prestofuoco/CUTIE-CITRUS/README.md

# computational imaging & telemetry for reconnaissance under suborbit
see CUTIE-CITRUS.pdf for schematics, and layout.pdf for PCB layout.
