prestofuoco/CUTIE-CITRUS/pcb/CUTIE-CITRUS.pdf

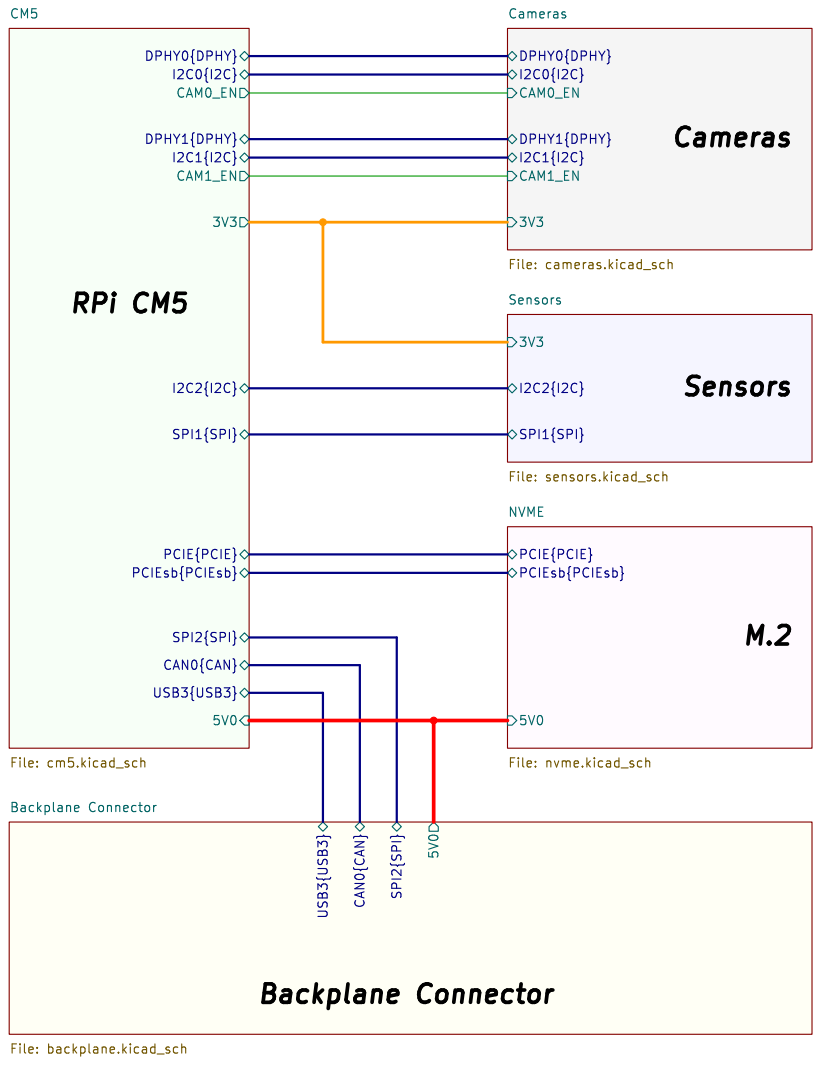
[picture p1: page 1]

I2C1{I2C} Cameras File: cameras.kicad_sch Backplane Connector

SPI1{SPI} Sensors File: sensors.kicad_sch

Id: 1/8 Title: CUTIE-CITRUS PCB

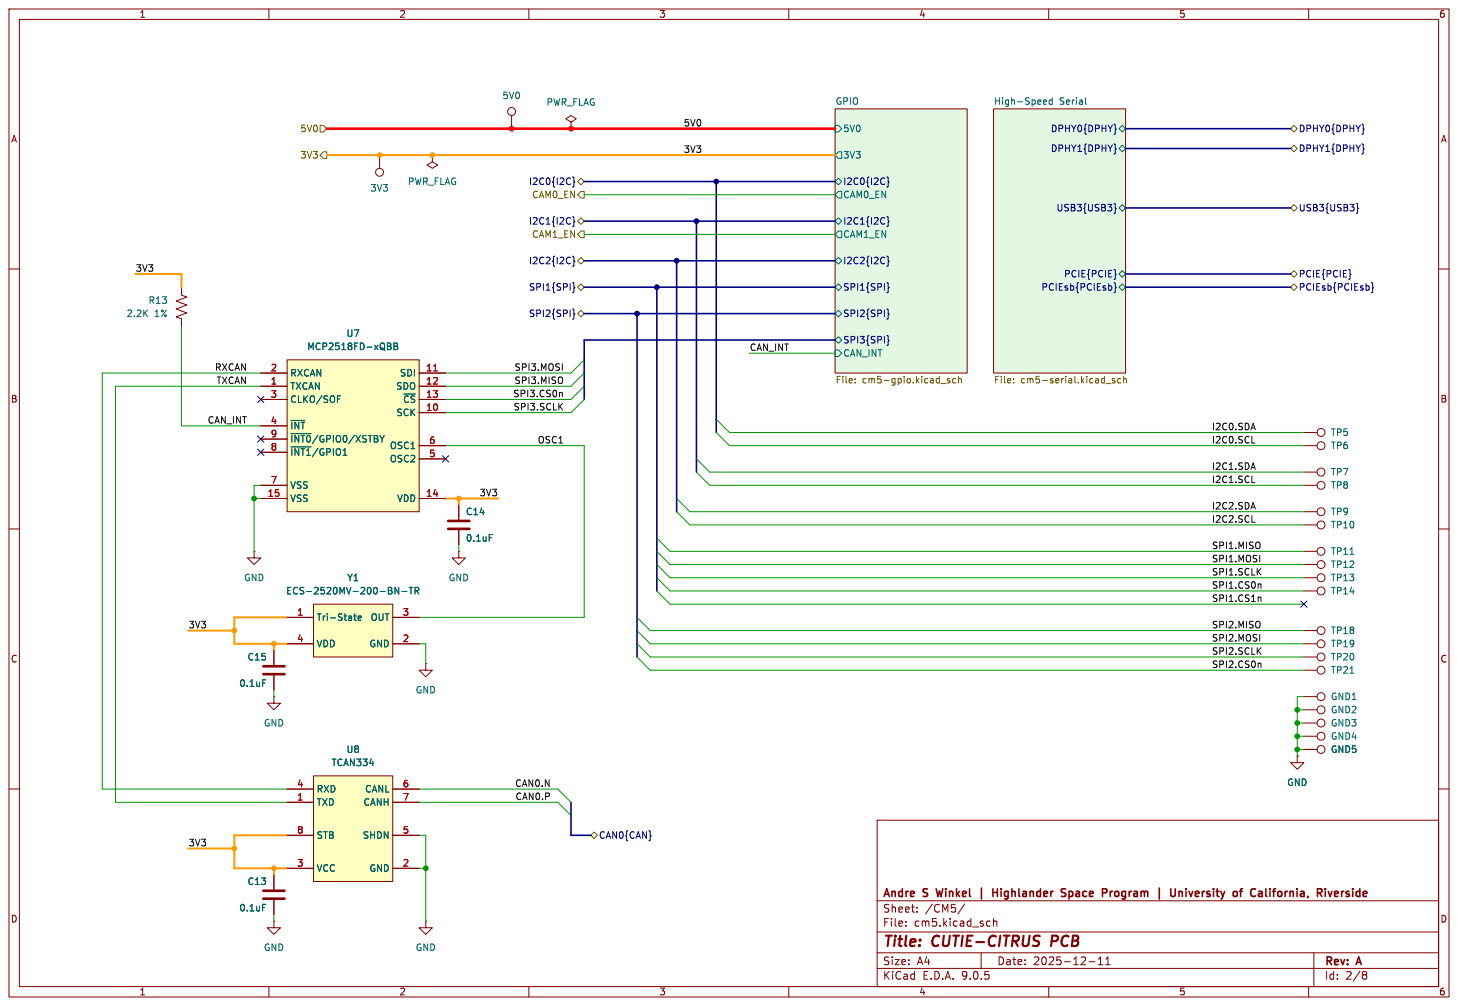
[picture p2: page 2]

Id: 2/8 Title: CUTIE-CITRUS PCB

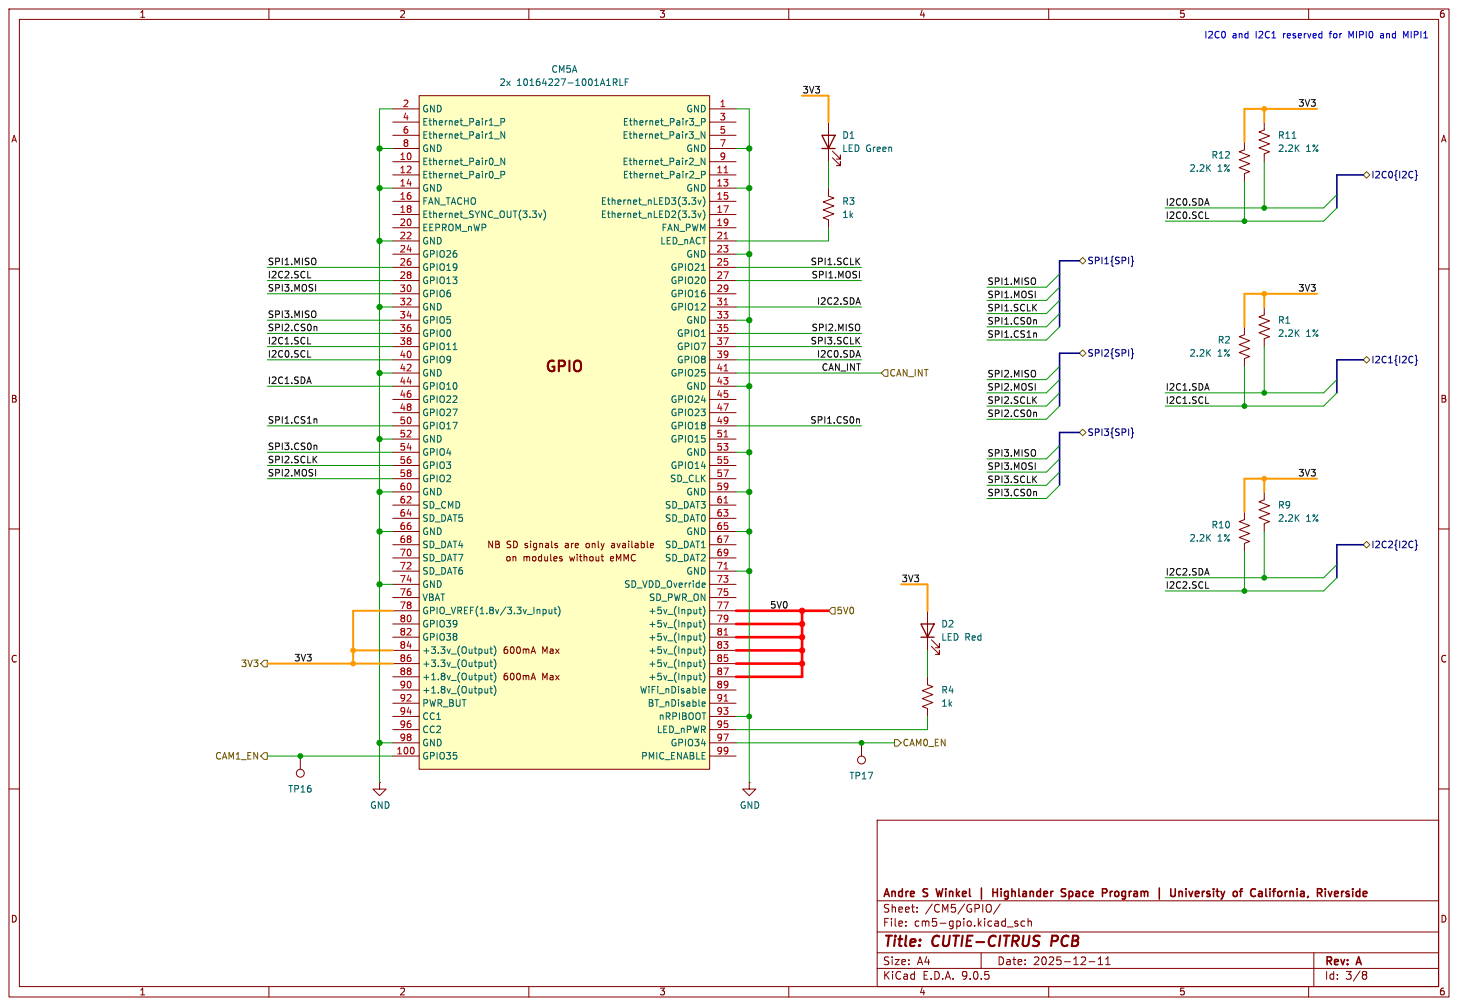
[picture p3: page 3]

I2C0 and I2C1 reserved for MIPI0 and MIPI1

NB SD signals are only available

Id: 3/8 Title: CUTIE-CITRUS PCB

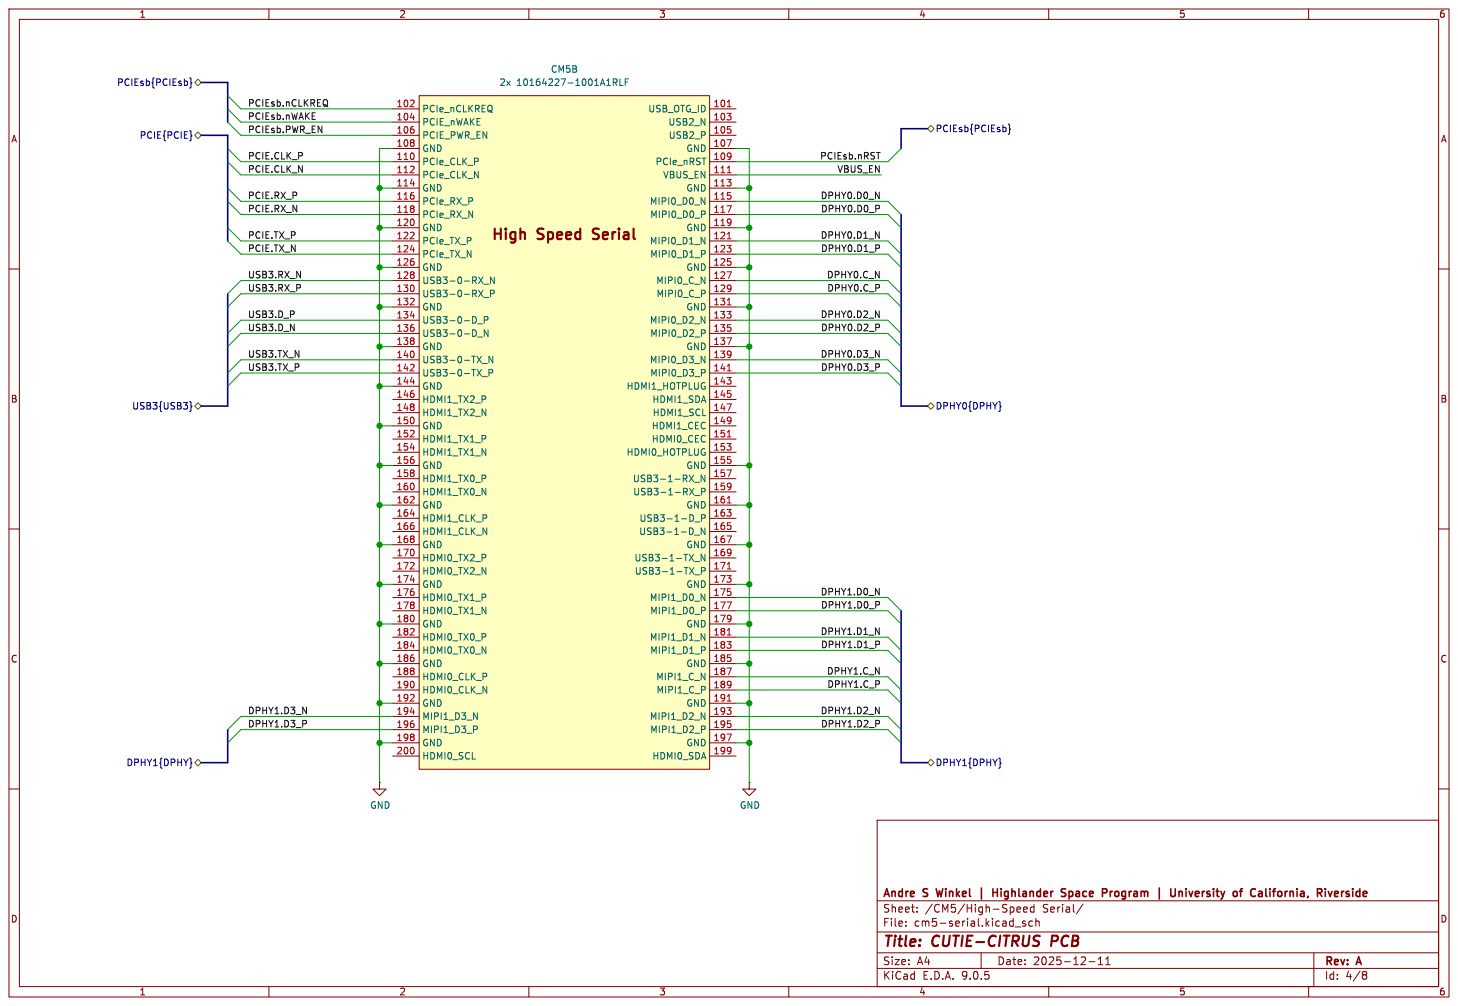
[picture p4: page 4]

Id: 4/8 Title: CUTIE-CITRUS PCB

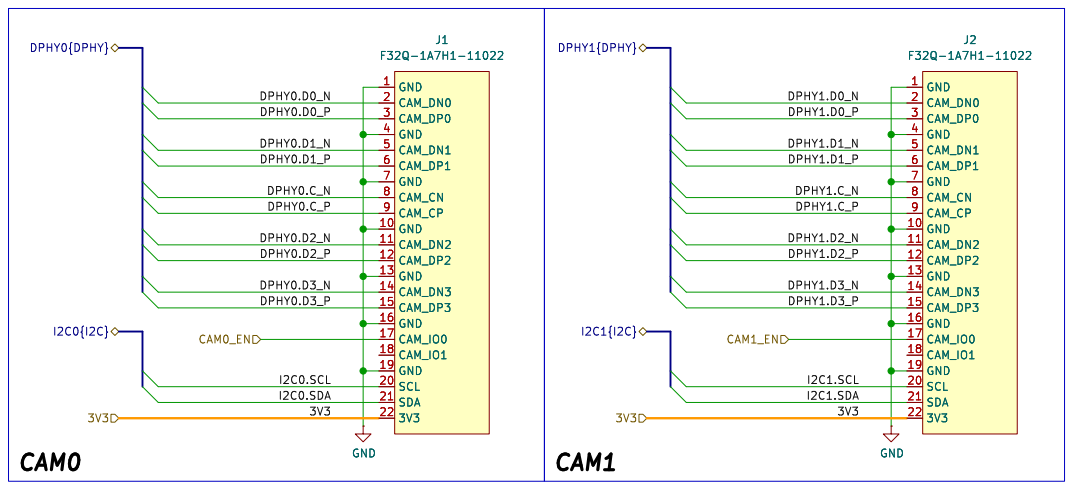
[picture p5: page 5]

Id: 5/8 Title: CUTIE-CITRUS PCB

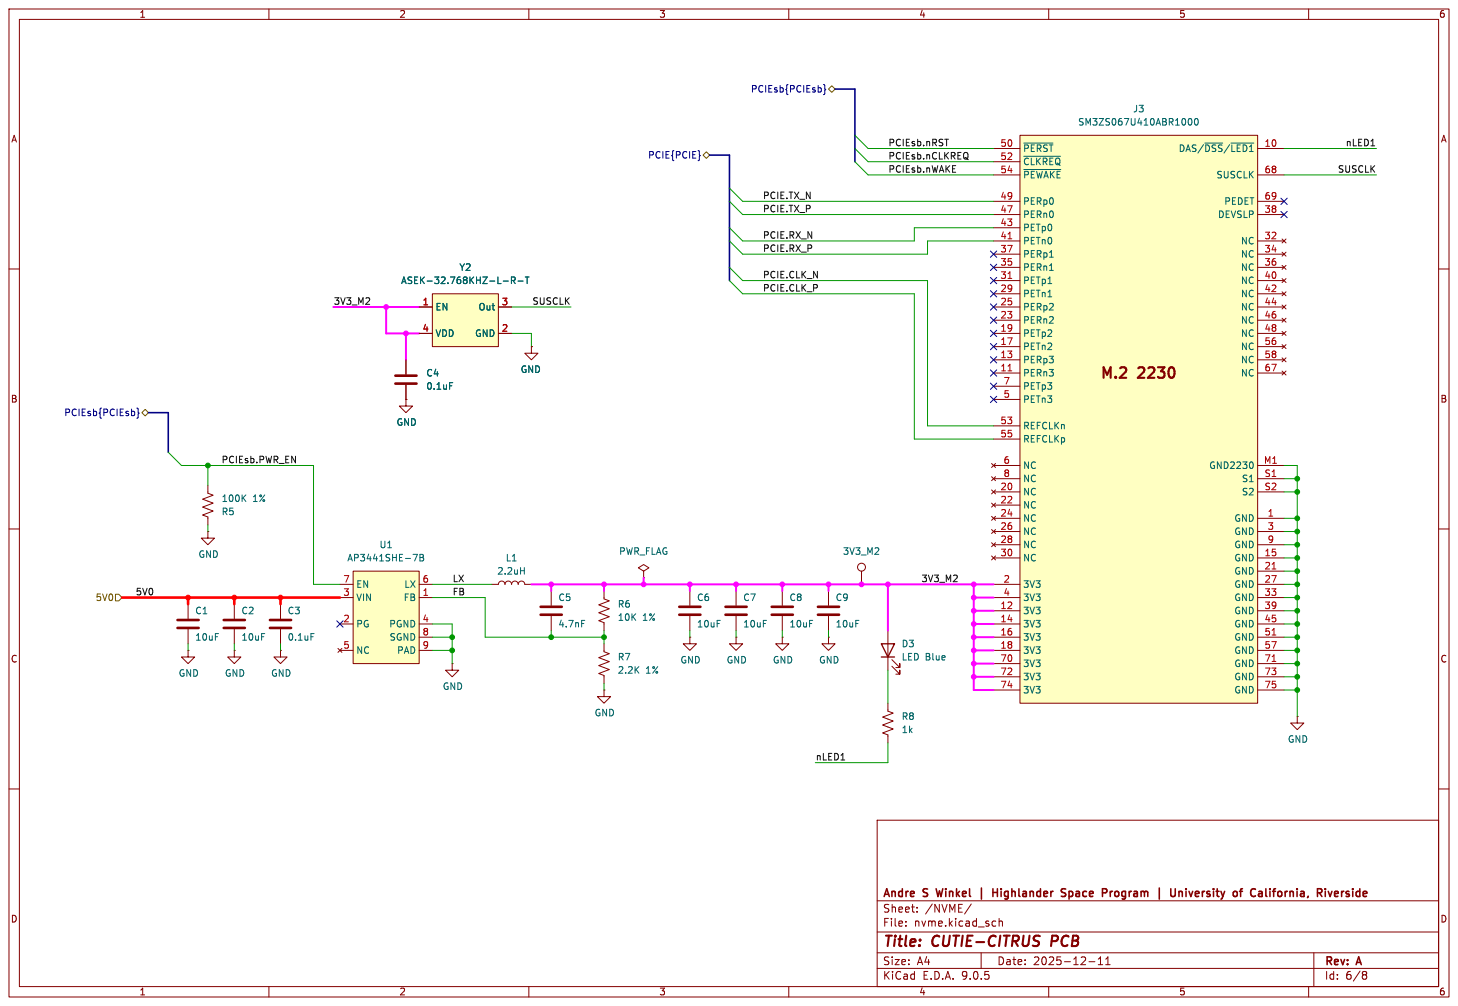
[picture p6: page 6]

PCIEsb.nRST PCIEsb.nCLKREQ

EN 7 VIN 3 PG 2 NC 5

Id: 6/8 Title: CUTIE-CITRUS PCB

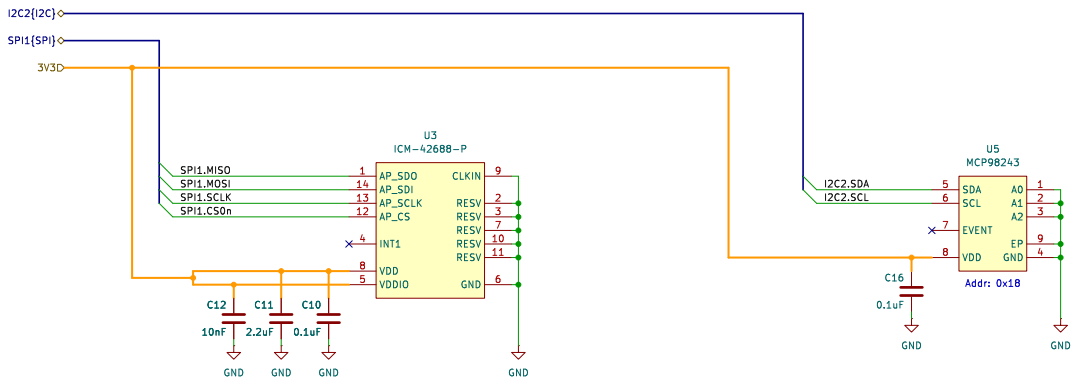
[picture p7: page 7]

Id: 7/8 Title: CUTIE-CITRUS PCB

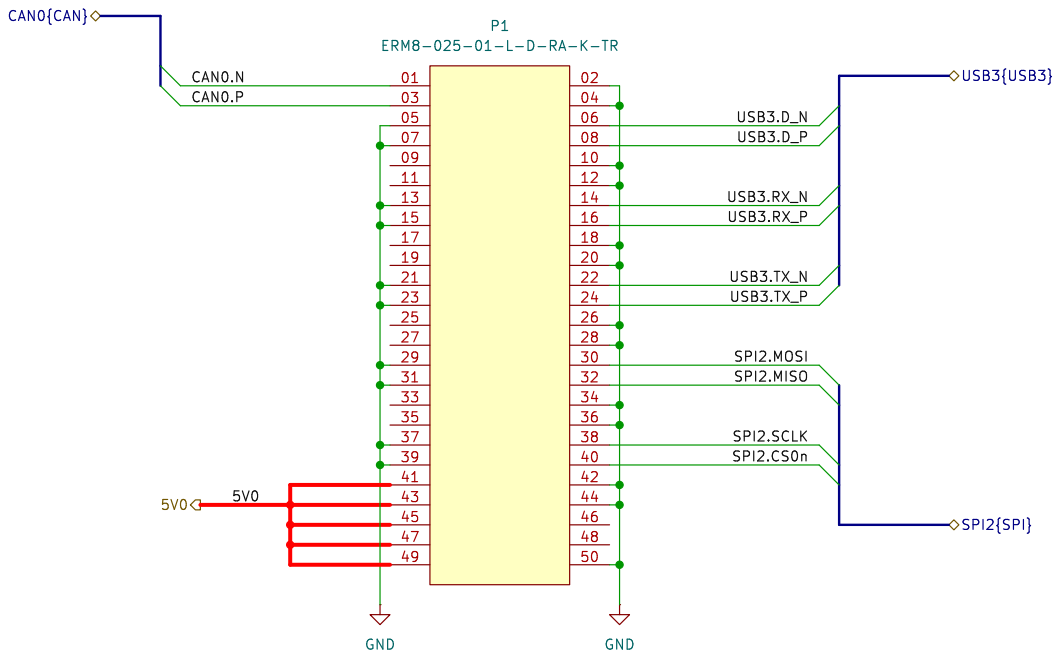
[picture p8: page 8]

47
49

Id: 8/8 Title: CUTIE-CITRUS PCB
