prestofuoco/CUTIE-CITRUS/pcb/CUTIE-CITRUS.kicad_pcb

## KiCad design pcb/CUTIE-CITRUS.kicad_pcb (2026-01-16)

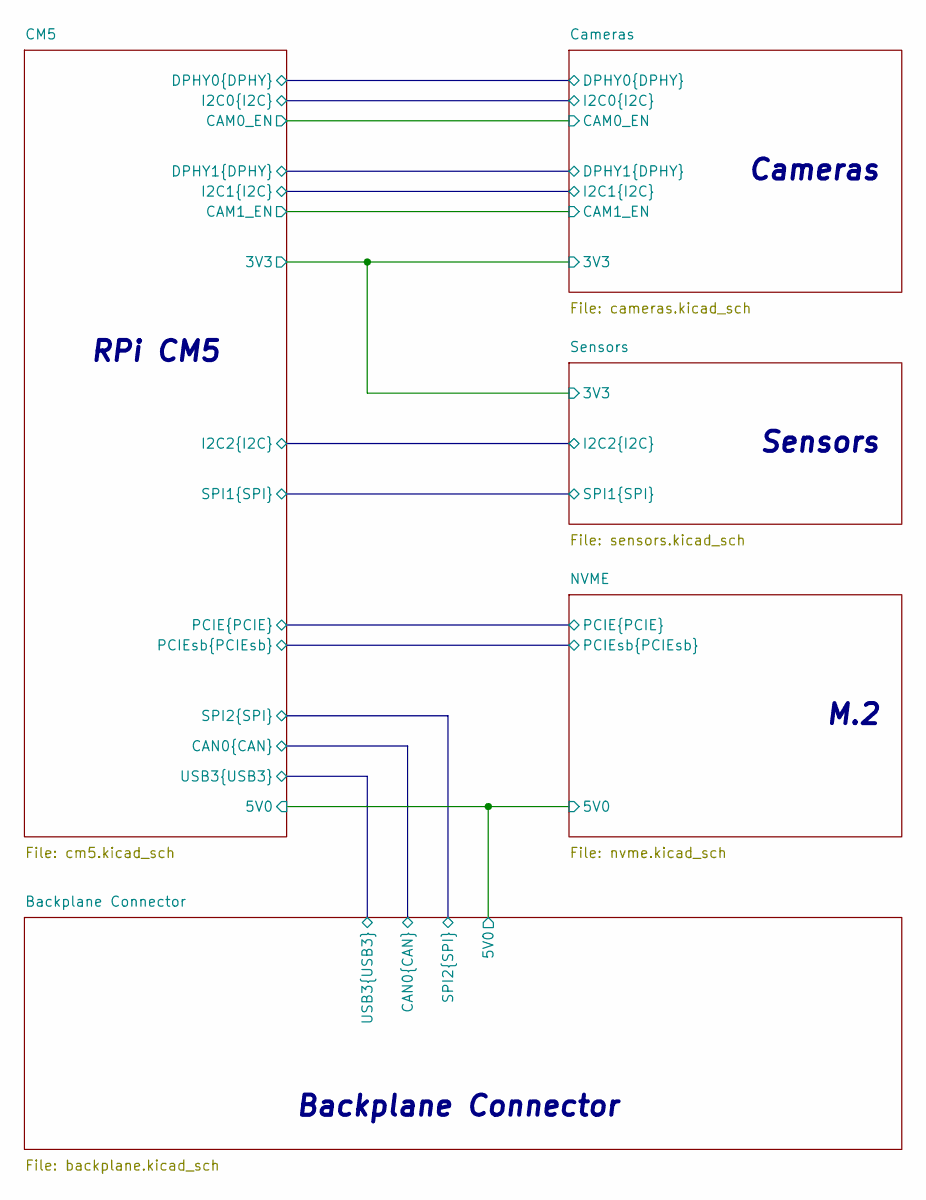
[picture p13: schematic CUTIE-CITRUS.kicad_sch, CUTIE-CITRUS PCB]

Notes on the sheet:
Cameras
Backplane Connector
Sensors
M.2
RPi CM5

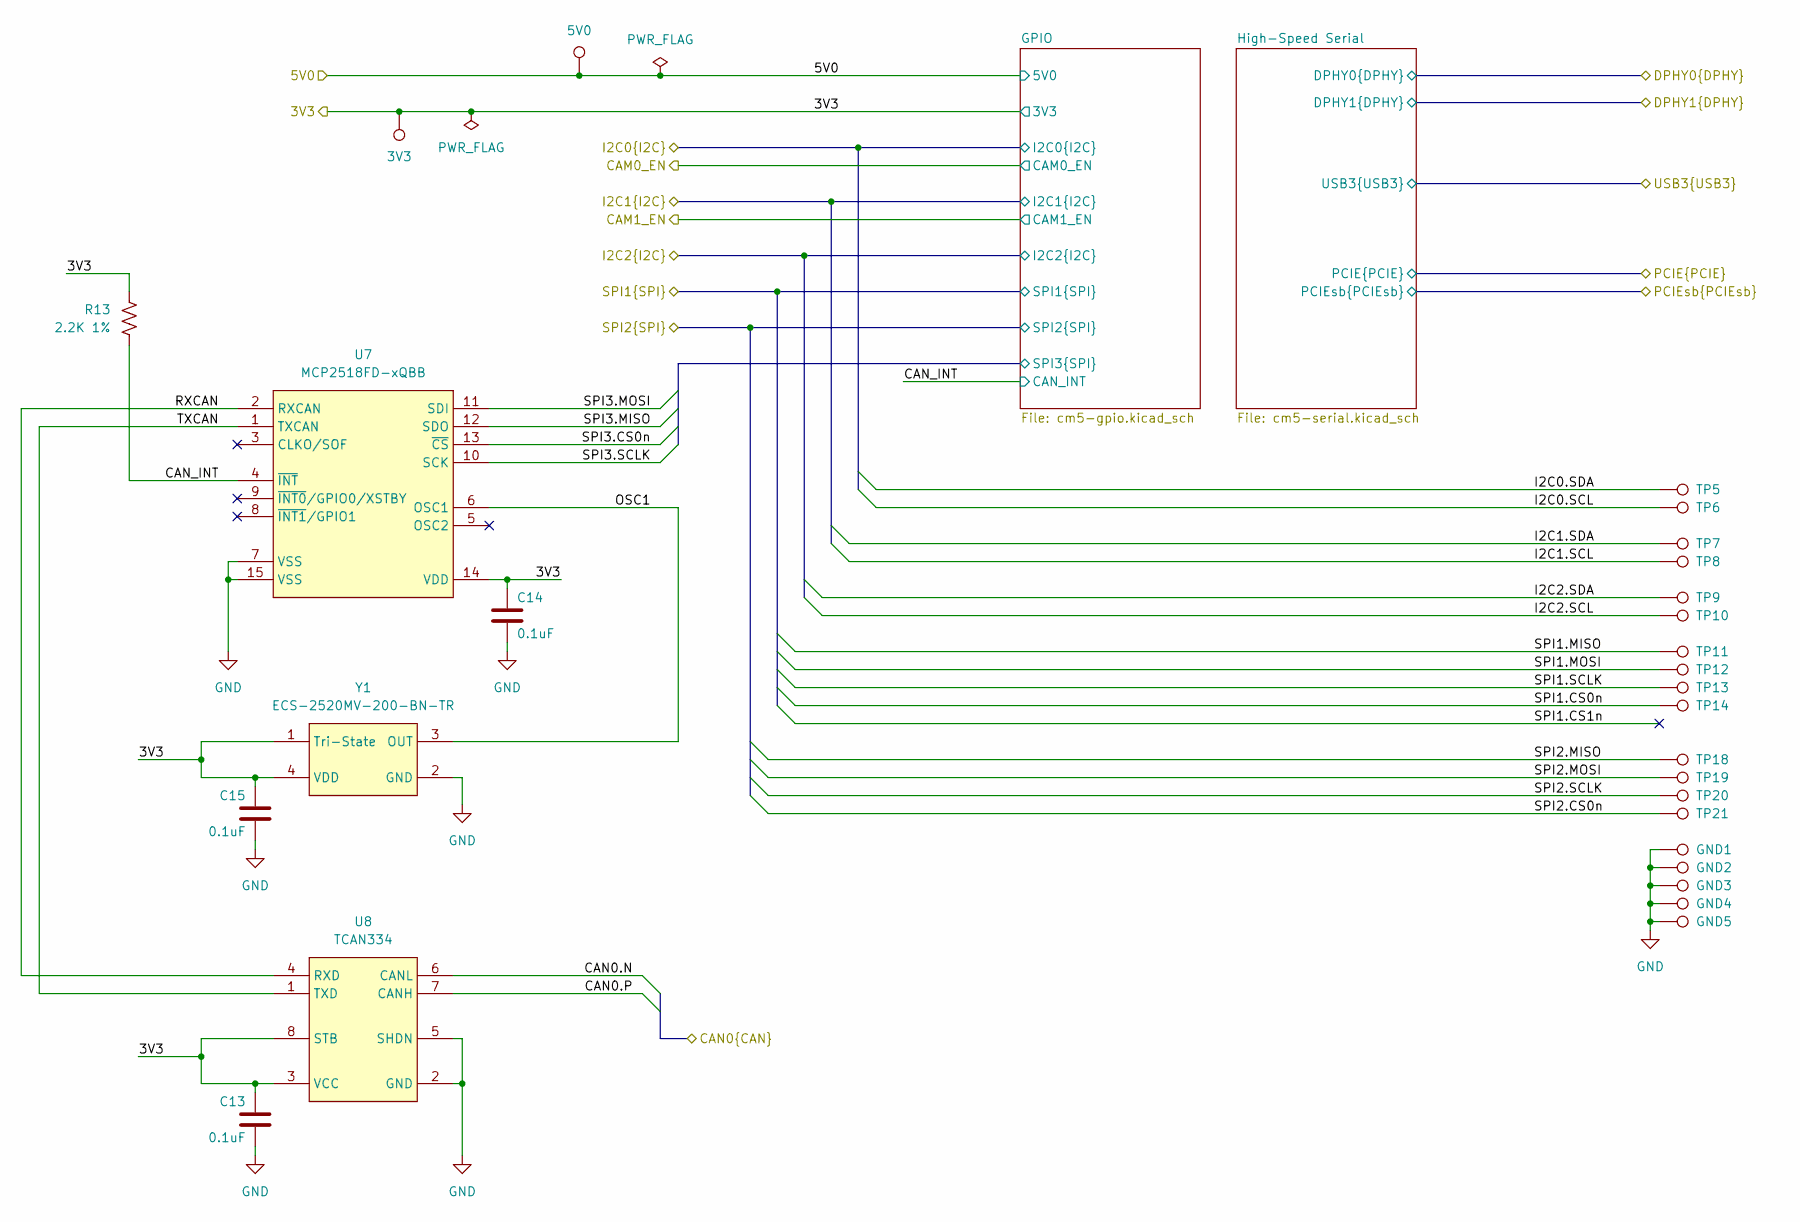
[picture p14: schematic cm5.kicad_sch, CUTIE-CITRUS PCB]

Parts:
3V3, 5V0: TestPoint; TestPoint_Pad_D2.0mm
C13, C14, C15: 0.1uF; C_0402_1005Metric; Part Description 0.1uF 10% 16V Ceramic Capacitor X7R 040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
GND1, GND2, GND3, GND4, GND5: TestPoint; TestPoint_Pad_D1.0mm
R13: 2.2K 1%; R_0402_1005Metric; Part Description Resistor 2.2K M1005 1% 63mW
TP5, TP6, TP7, TP8, TP9, TP10, TP11, TP12, TP13, TP14, TP18, TP19, TP20, TP21: TestPoint; TestPoint_Pad_D1.0mm
U7: MCP2518FD-xQBB; DFN-14-1EP_3x4.5mm_P0.65mm_EP1.65x4.25mm
U8: TCAN334; JEITA_SOIC-8_3.9x4.9mm_P1.27mm
Y1: ECS-2520MV-200-BN-TR; Oscillator_SMD_ECS_2520MV-xxx-xx-4Pin_2.5x2.0mm

Connections:
/Backplane Connector/5V0: 5V0.1; also elsewhere on the board
/Backplane Connector/CAN0.N: U8.6 (CANL); also elsewhere on the board
/Backplane Connector/CAN0.P: U8.7 (CANH); also elsewhere on the board
/Backplane Connector/SPI2.CS0n: TP21.1; also elsewhere on the board
/Backplane Connector/SPI2.MISO: TP18.1; also elsewhere on the board
/Backplane Connector/SPI2.MOSI: TP19.1; also elsewhere on the board
/Backplane Connector/SPI2.SCLK: TP20.1; also elsewhere on the board
/CM5/3V3: 3V3.1, C13.1, C14.1, C15.1, R13.1, U7.14 (VDD), U8.3 (VCC), U8.8 (STB), Y1.1 (Tri-State), Y1.4 (VDD); also elsewhere on the board
/CM5/CAN_INT: R13.2, U7.4 (~INT); also elsewhere on the board
/CM5/GPIO/SPI3.CS0n: U7.13 (~CS); also elsewhere on the board
/CM5/GPIO/SPI3.MISO: U7.12 (SDO); also elsewhere on the board
/CM5/GPIO/SPI3.MOSI: U7.11 (SDI); also elsewhere on the board
/CM5/GPIO/SPI3.SCLK: U7.10 (SCK); also elsewhere on the board
/CM5/I2C0.SCL: TP6.1; also elsewhere on the board
/CM5/I2C0.SDA: TP5.1; also elsewhere on the board
/CM5/I2C1.SCL: TP8.1; also elsewhere on the board
/CM5/I2C1.SDA: TP7.1; also elsewhere on the board
/CM5/I2C2.SCL: TP10.1; also elsewhere on the board
/CM5/I2C2.SDA: TP9.1; also elsewhere on the board
/CM5/OSC1: U7.6 (OSC1), Y1.3 (OUT)
/CM5/RXCAN: U7.2 (RXCAN), U8.4 (RXD)
/CM5/SPI1.CS0n: TP14.1; also elsewhere on the board
/CM5/SPI1.MISO: TP11.1; also elsewhere on the board
/CM5/SPI1.MOSI: TP12.1; also elsewhere on the board
/CM5/SPI1.SCLK: TP13.1; also elsewhere on the board
/CM5/TXCAN: U7.1 (TXCAN), U8.1 (TXD)
GND: C13.2, C14.2, C15.2, GND1.1, GND2.1, GND3.1, GND4.1, GND5.1, U7.7 (VSS), U7.15 (VSS), U8.2 (GND), U8.5 (SHDN), Y1.2 (GND); also elsewhere on the board

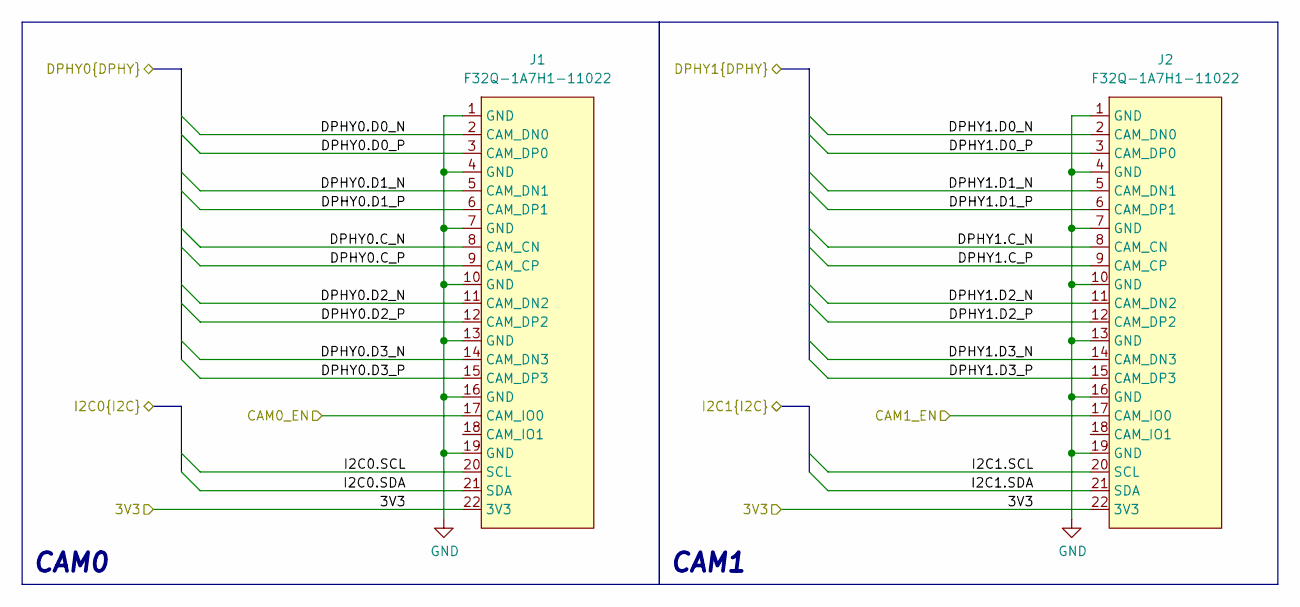
[picture p15: schematic cameras.kicad_sch, CUTIE-CITRUS PCB]

Parts:
J1, J2: F32Q-1A7H1-11022; Hirose_FH12-22S-0.5SH_1x22-1MP_P0.50mm_Horizontal

Connections:
/CM5/3V3: J1.22 (3V3), J2.22 (3V3); also elsewhere on the board
/CM5/CAM0_EN: J1.17 (CAM_IO0); also elsewhere on the board
/CM5/CAM1_EN: J2.17 (CAM_IO0); also elsewhere on the board
/CM5/DPHY0.C_N: J1.8 (CAM_CN); also elsewhere on the board
/CM5/DPHY0.C_P: J1.9 (CAM_CP); also elsewhere on the board
/CM5/DPHY0.D0_N: J1.2 (CAM_DN0); also elsewhere on the board
/CM5/DPHY0.D0_P: J1.3 (CAM_DP0); also elsewhere on the board
/CM5/DPHY0.D1_N: J1.5 (CAM_DN1); also elsewhere on the board
/CM5/DPHY0.D1_P: J1.6 (CAM_DP1); also elsewhere on the board
/CM5/DPHY0.D2_N: J1.11 (CAM_DN2); also elsewhere on the board
/CM5/DPHY0.D2_P: J1.12 (CAM_DP2); also elsewhere on the board
/CM5/DPHY0.D3_N: J1.14 (CAM_DN3); also elsewhere on the board
/CM5/DPHY0.D3_P: J1.15 (CAM_DP3); also elsewhere on the board
/CM5/DPHY1.C_N: J2.8 (CAM_CN); also elsewhere on the board
/CM5/DPHY1.C_P: J2.9 (CAM_CP); also elsewhere on the board
/CM5/DPHY1.D0_N: J2.2 (CAM_DN0); also elsewhere on the board
/CM5/DPHY1.D0_P: J2.3 (CAM_DP0); also elsewhere on the board
/CM5/DPHY1.D1_N: J2.5 (CAM_DN1); also elsewhere on the board
/CM5/DPHY1.D1_P: J2.6 (CAM_DP1); also elsewhere on the board
/CM5/DPHY1.D2_N: J2.11 (CAM_DN2); also elsewhere on the board
/CM5/DPHY1.D2_P: J2.12 (CAM_DP2); also elsewhere on the board
/CM5/DPHY1.D3_N: J2.14 (CAM_DN3); also elsewhere on the board
/CM5/DPHY1.D3_P: J2.15 (CAM_DP3); also elsewhere on the board
/CM5/I2C0.SCL: J1.20 (SCL); also elsewhere on the board
/CM5/I2C0.SDA: J1.21 (SDA); also elsewhere on the board
/CM5/I2C1.SCL: J2.20 (SCL); also elsewhere on the board
/CM5/I2C1.SDA: J2.21 (SDA); also elsewhere on the board
GND: J1.1 (GND), J1.4 (GND), J1.7 (GND), J1.10 (GND), J1.13 (GND), J1.16 (GND), J1.19 (GND), J2.1 (GND), J2.4 (GND), J2.7 (GND), J2.10 (GND), J2.13 (GND), J2.16 (GND), J2.19 (GND); also elsewhere on the board

Notes on the sheet:
CAM1
CAM0

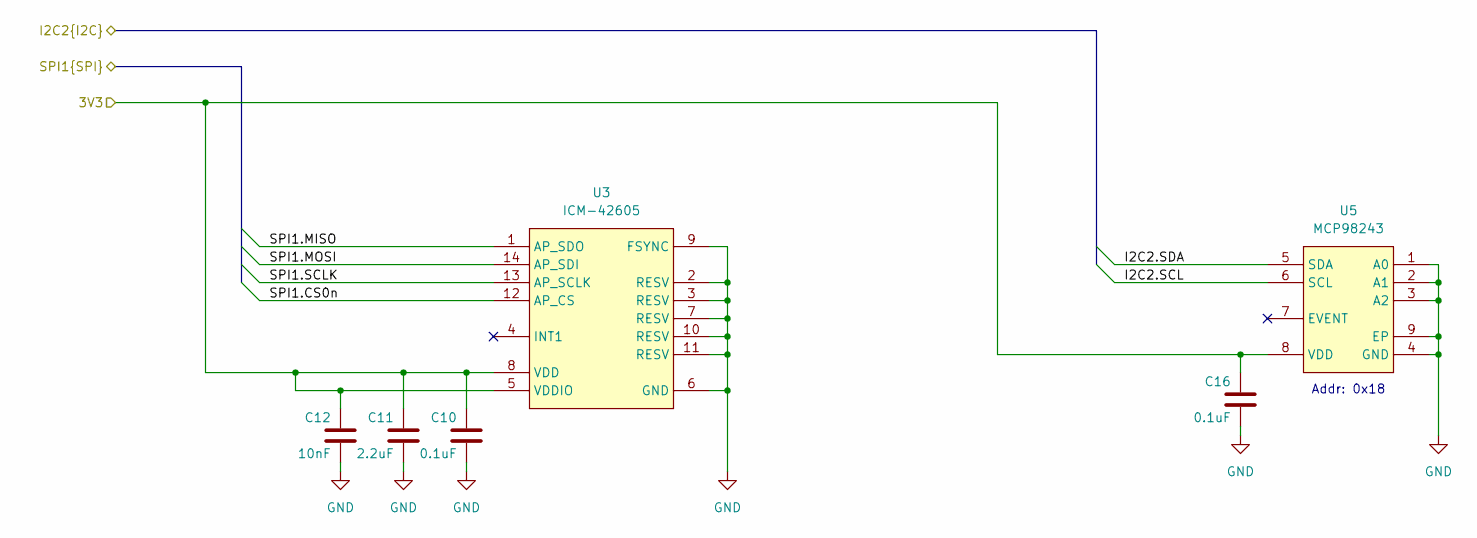
[picture p16: schematic sensors.kicad_sch, CUTIE-CITRUS PCB]

Parts:
C10, C16: 0.1uF; C_0402_1005Metric
C11: 2.2uF; C_0402_1005Metric; Part Description 4.7nF capacitor 0402
C12: 10nF; C_0402_1005Metric; Part Description 4.7nF capacitor 0402
U3: ICM-42605; LGA-14_3x2.5mm_P0.5mm_LayoutBorder3x4y
U5: MCP98243; DFN-8-1EP_3x2mm_P0.5mm_EP1.3x1.5mm

Connections:
/CM5/3V3: C10.1, C11.1, C12.1, C16.1, U3.5 (VDDIO), U3.8 (VDD), U5.8 (VDD); also elsewhere on the board
/CM5/I2C2.SCL: U5.6 (SCL); also elsewhere on the board
/CM5/I2C2.SDA: U5.5 (SDA); also elsewhere on the board
/CM5/SPI1.CS0n: U3.12 (AP_CS); also elsewhere on the board
/CM5/SPI1.MISO: U3.1 (AP_SDO); also elsewhere on the board
/CM5/SPI1.MOSI: U3.14 (AP_SDI); also elsewhere on the board
/CM5/SPI1.SCLK: U3.13 (AP_SCLK); also elsewhere on the board
GND: C10.2, C11.2, C12.2, C16.2, U3.2 (RESV), U3.3 (RESV), U3.6 (GND), U3.7 (RESV), U3.9 (FSYNC), U3.10 (RESV), U3.11 (RESV), U5.1 (A0), U5.2 (A1), U5.3 (A2), U5.4 (GND), U5.9 (EP); also elsewhere on the board

Notes on the sheet:
Addr: 0x18

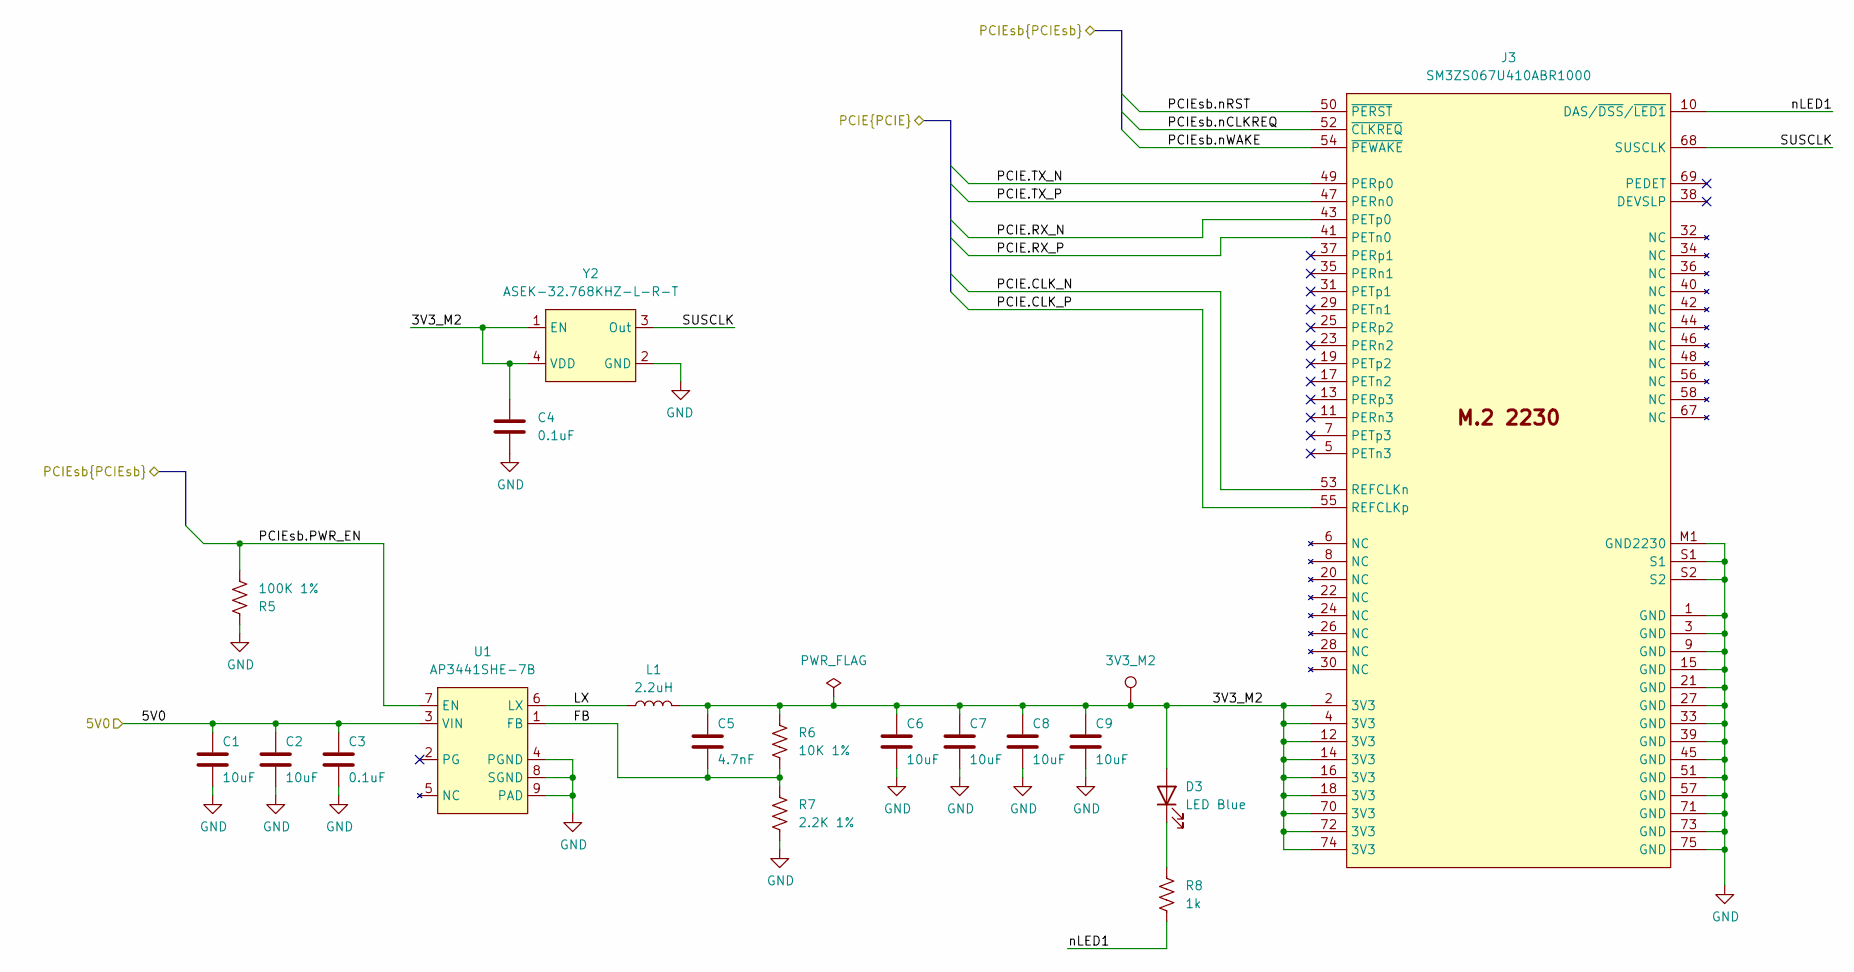
[picture p17: schematic nvme.kicad_sch, CUTIE-CITRUS PCB]

Parts:
3V3_M2: TestPoint; TestPoint_Pad_D1.0mm
C1, C2, C6, C7, C8, C9: 10uF; C_0805_2012Metric
C3, C4: 0.1uF; C_0402_1005Metric
C5: 4.7nF; C_0402_1005Metric
D3: LED Blue; LED_0603_1608Metric
J3: SM3ZS067U410ABR1000; 2230m2
L1: 2.2uH; L_Vishay_IHLP-1616
R5: 100K 1%; R_0402_1005Metric
R6: 10K 1%; R_0402_1005Metric
R7: 2.2K 1%; R_0402_1005Metric
R8: 1k; R_0402_1005Metric
U1: AP3441SHE-7B; DFN-8-1EP_2x2mm_P0.5mm_EP1.05x1.75mm
Y2: ASEK-32.768KHZ-L-R-T; Crystal_SMD_3225-4Pin_3.2x2.5mm

Connections:
/Backplane Connector/5V0: C1.1, C2.1, C3.1, U1.3 (VIN); also elsewhere on the board
/CM5/PCIE.CLK_N: J3.53 (REFCLKn); also elsewhere on the board
/CM5/PCIE.CLK_P: J3.55 (REFCLKp); also elsewhere on the board
/CM5/PCIE.RX_N: J3.43 (PETp0); also elsewhere on the board
/CM5/PCIE.RX_P: J3.41 (PETn0); also elsewhere on the board
/CM5/PCIE.TX_N: J3.49 (PERp0); also elsewhere on the board
/CM5/PCIE.TX_P: J3.47 (PERn0); also elsewhere on the board
/CM5/PCIEsb.PWR_EN: R5.1, U1.7 (EN); also elsewhere on the board
/CM5/PCIEsb.nCLKREQ: J3.52 (~CLKREQ); also elsewhere on the board
/CM5/PCIEsb.nRST: J3.50 (~PERST); also elsewhere on the board
/CM5/PCIEsb.nWAKE: J3.54 (~PEWAKE); also elsewhere on the board
/NVME/3V3_M2: 3V3_M2.1, C4.1, C5.1, C6.1, C7.1, C8.1, C9.1, D3.2 (A), J3.2 (3V3), J3.4 (3V3), J3.12 (3V3), J3.14 (3V3), J3.16 (3V3), J3.18 (3V3), J3.70 (3V3), J3.72 (3V3), J3.74 (3V3), L1.2, R6.1, Y2.1 (EN), Y2.4 (VDD)
/NVME/FB: C5.2, R6.2, R7.1, U1.1 (FB)
/NVME/LX: L1.1, U1.6 (LX)
/NVME/SUSCLK: J3.68 (SUSCLK), Y2.3 (Out)
/NVME/nLED1: J3.10 (DAS/~DSS/~LED1), R8.2
GND: C1.2, C2.2, C3.2, C4.2, C6.2, C7.2, C8.2, C9.2, J3.1 (GND), J3.3 (GND), J3.9 (GND), J3.15 (GND), J3.21 (GND), J3.27 (GND), J3.33 (GND), J3.39 (GND), J3.45 (GND), J3.51 (GND), J3.57 (GND), J3.71 (GND), J3.73 (GND), J3.75 (GND), J3.M1 (GND2230), J3.S1, J3.S2, R5.2, R7.2, U1.4 (PGND), U1.8 (SGND), U1.9 (PAD), Y2.2 (GND); also elsewhere on the board
unnamed: D3.1 (K), R8.1

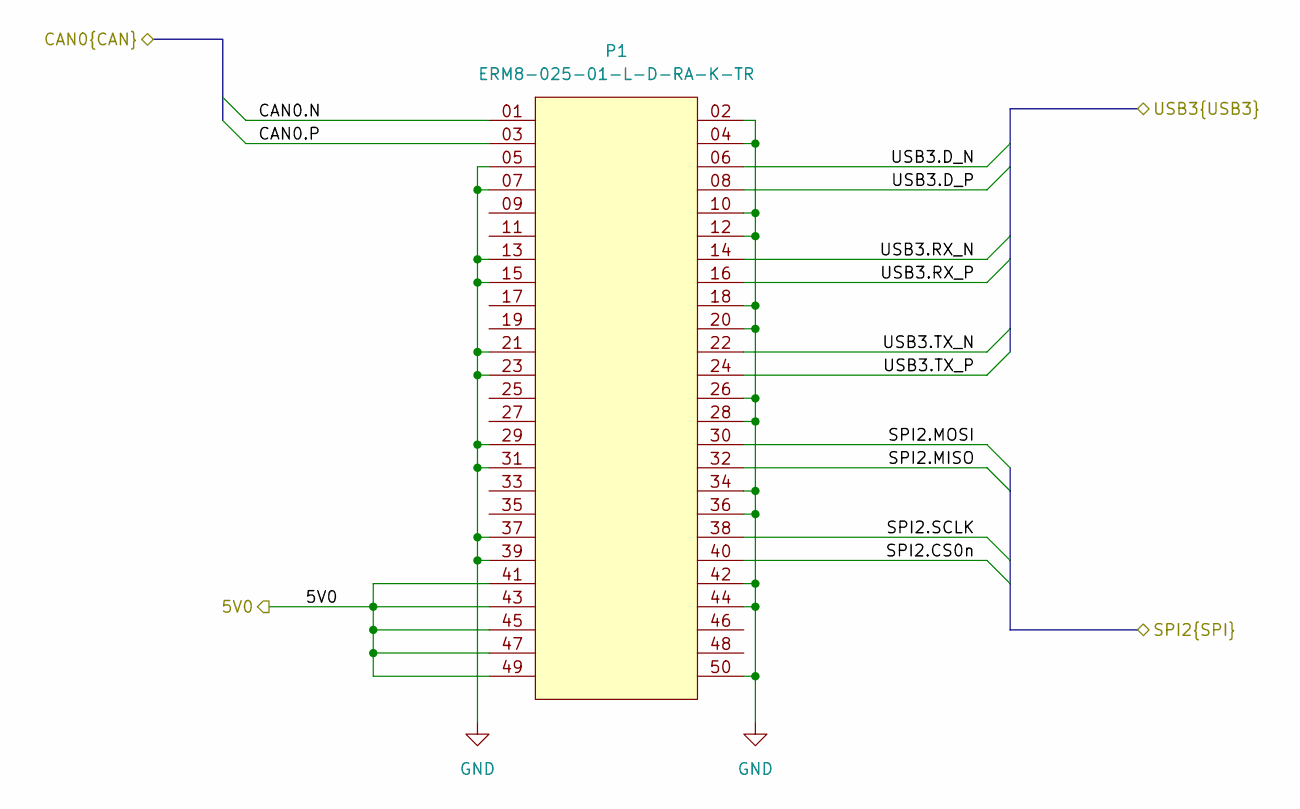
[picture p18: schematic backplane.kicad_sch, CUTIE-CITRUS PCB]

Parts:
P1: ERM8-025-01-L-D-RA-K-TR; SAMTEC_ERM8-025-XX-X-D-RA-XX

Connections:
/Backplane Connector/5V0: P1.41, P1.43, P1.45, P1.47, P1.49; also elsewhere on the board
/Backplane Connector/CAN0.N: P1.01; also elsewhere on the board
/Backplane Connector/CAN0.P: P1.03; also elsewhere on the board
/Backplane Connector/SPI2.CS0n: P1.40; also elsewhere on the board
/Backplane Connector/SPI2.MISO: P1.32; also elsewhere on the board
/Backplane Connector/SPI2.MOSI: P1.30; also elsewhere on the board
/Backplane Connector/SPI2.SCLK: P1.38; also elsewhere on the board
/Backplane Connector/USB3.D_N: P1.06; also elsewhere on the board
/Backplane Connector/USB3.D_P: P1.08; also elsewhere on the board
/Backplane Connector/USB3.RX_N: P1.14; also elsewhere on the board
/Backplane Connector/USB3.RX_P: P1.16; also elsewhere on the board
/Backplane Connector/USB3.TX_N: P1.22; also elsewhere on the board
/Backplane Connector/USB3.TX_P: P1.24; also elsewhere on the board
GND: P1.02, P1.04, P1.05, P1.07, P1.10, P1.12, P1.13, P1.15, P1.18, P1.20, P1.21, P1.23, P1.26, P1.28, P1.29, P1.31, P1.34, P1.36, P1.37, P1.39, P1.42, P1.44, P1.50; also elsewhere on the board

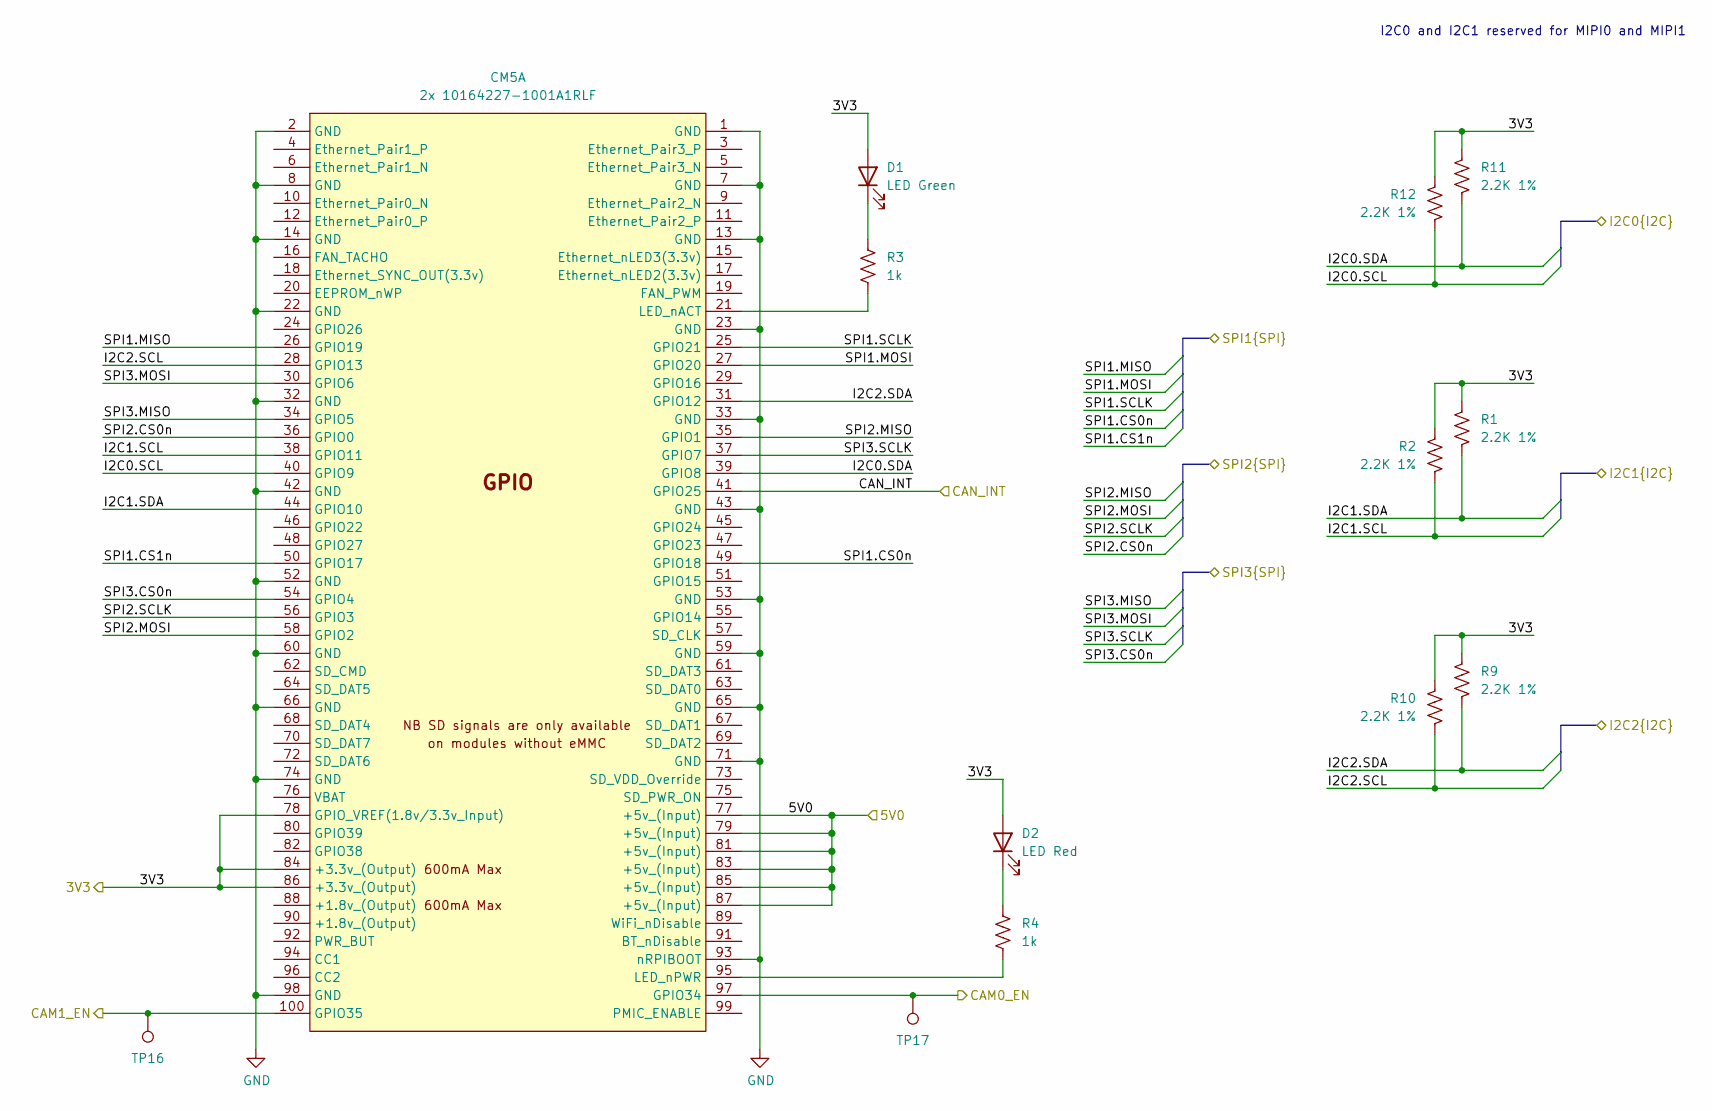
[picture p19: schematic cm5-gpio.kicad_sch, CUTIE-CITRUS PCB]

Parts:
CM5: 2x 10164227-1001A1RLF; RPi-CM5
D1: LED Green; LED_0603_1608Metric
D2: LED Red; LED_0603_1608Metric
R1, R2, R9, R10, R11, R12: 2.2K 1%; R_0402_1005Metric
R3, R4: 1k; R_0402_1005Metric
TP16, TP17: TestPoint; TestPoint_Pad_D1.0mm

Connections:
/Backplane Connector/5V0: CM5.77 (+5v_(Input)), CM5.79 (+5v_(Input)), CM5.81 (+5v_(Input)), CM5.83 (+5v_(Input)), CM5.85 (+5v_(Input)), CM5.87 (+5v_(Input)); also elsewhere on the board
/Backplane Connector/SPI2.CS0n: CM5.36 (GPIO0); also elsewhere on the board
/Backplane Connector/SPI2.MISO: CM5.35 (GPIO1); also elsewhere on the board
/Backplane Connector/SPI2.MOSI: CM5.58 (GPIO2); also elsewhere on the board
/Backplane Connector/SPI2.SCLK: CM5.56 (GPIO3); also elsewhere on the board
/CM5/3V3: CM5.78 (GPIO_VREF(1.8v/3.3v_Input)), CM5.84 (+3.3v_(Output)), CM5.86 (+3.3v_(Output)), D1.2 (A), D2.2 (A), R1.1, R2.1, R9.1, R10.1, R11.1, R12.1; also elsewhere on the board
/CM5/CAM0_EN: CM5.97 (GPIO34), TP17.1; also elsewhere on the board
/CM5/CAM1_EN: CM5.100 (GPIO35), TP16.1; also elsewhere on the board
/CM5/CAN_INT: CM5.41 (GPIO25); also elsewhere on the board
/CM5/GPIO/SPI3.CS0n: CM5.54 (GPIO4); also elsewhere on the board
/CM5/GPIO/SPI3.MISO: CM5.34 (GPIO5); also elsewhere on the board
/CM5/GPIO/SPI3.MOSI: CM5.30 (GPIO6); also elsewhere on the board
/CM5/GPIO/SPI3.SCLK: CM5.37 (GPIO7); also elsewhere on the board
/CM5/I2C0.SCL: CM5.40 (GPIO9), R12.2; also elsewhere on the board
/CM5/I2C0.SDA: CM5.39 (GPIO8), R11.2; also elsewhere on the board
/CM5/I2C1.SCL: CM5.38 (GPIO11), R2.2; also elsewhere on the board
/CM5/I2C1.SDA: CM5.44 (GPIO10), R1.2; also elsewhere on the board
/CM5/I2C2.SCL: CM5.28 (GPIO13), R10.2; also elsewhere on the board
/CM5/I2C2.SDA: CM5.31 (GPIO12), R9.2; also elsewhere on the board
/CM5/SPI1.CS0n: CM5.49 (GPIO18); also elsewhere on the board
/CM5/SPI1.CS1n: CM5.50 (GPIO17)
/CM5/SPI1.MISO: CM5.26 (GPIO19); also elsewhere on the board
/CM5/SPI1.MOSI: CM5.27 (GPIO20); also elsewhere on the board
/CM5/SPI1.SCLK: CM5.25 (GPIO21); also elsewhere on the board
GND: CM5.1 (GND), CM5.2 (GND), CM5.7 (GND), CM5.8 (GND), CM5.13 (GND), CM5.14 (GND), CM5.22 (GND), CM5.23 (GND), CM5.32 (GND), CM5.33 (GND), CM5.42 (GND), CM5.43 (GND), CM5.52 (GND), CM5.53 (GND), CM5.59 (GND), CM5.60 (GND), CM5.65 (GND), CM5.66 (GND), CM5.71 (GND), CM5.74 (GND), CM5.93 (nRPIBOOT), CM5.98 (GND); also elsewhere on the board
unnamed: CM5.21 (LED_nACT), R3.2
unnamed: CM5.95 (LED_nPWR), R4.2
unnamed: D1.1 (K), R3.1
unnamed: D2.1 (K), R4.1

Notes on the sheet:
I2C0 and I2C1 reserved for MIPI0 and MIPI1

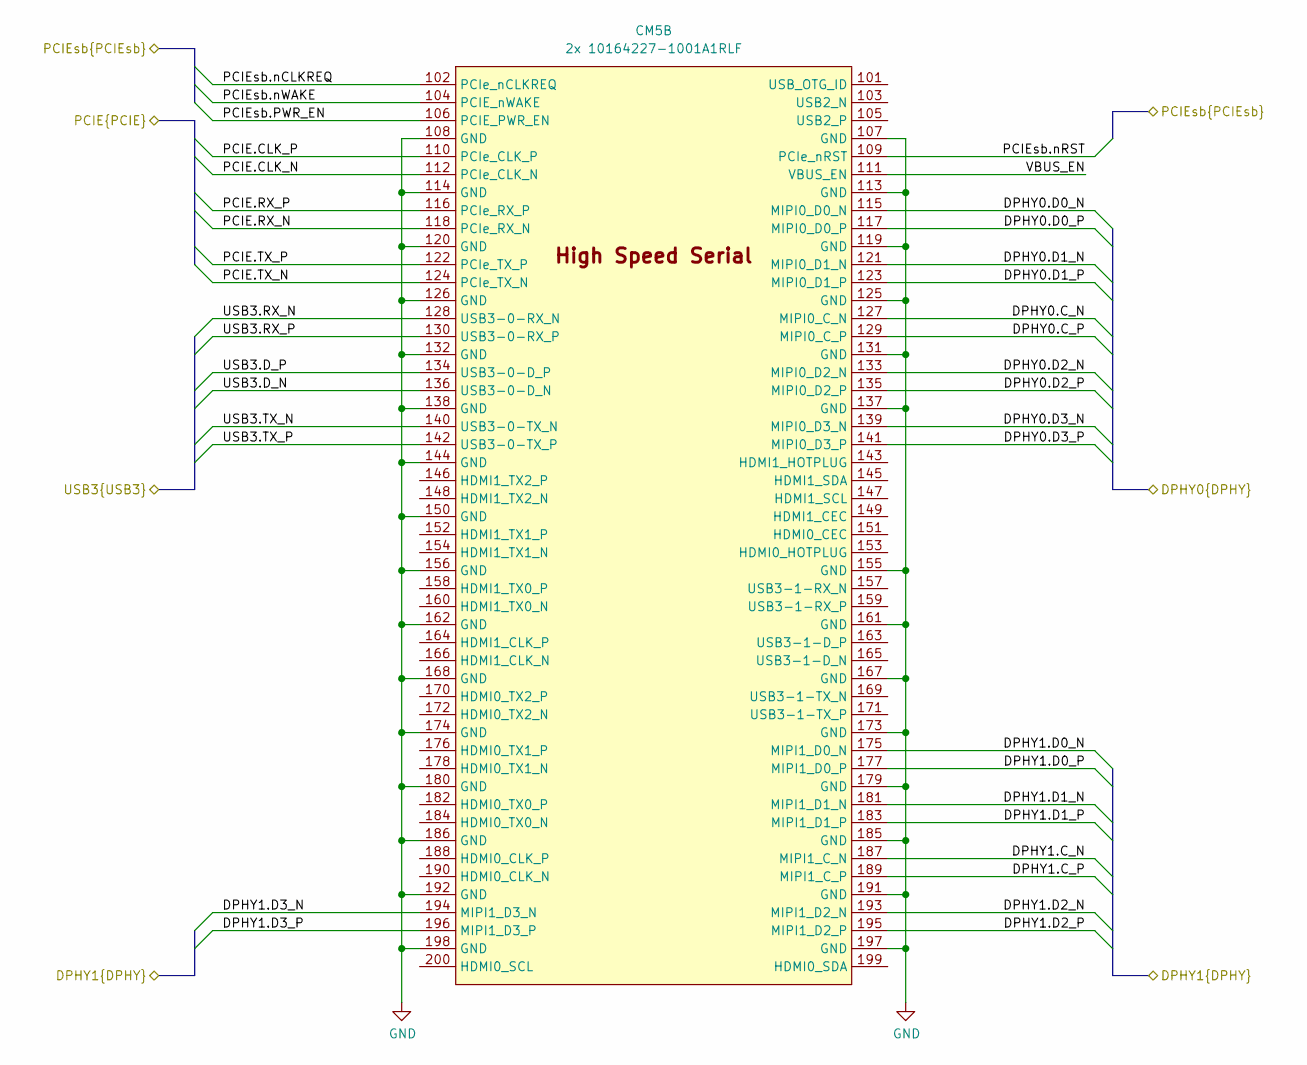
[picture p20: schematic cm5-serial.kicad_sch, CUTIE-CITRUS PCB]

Parts:
CM5: 2x 10164227-1001A1RLF; RPi-CM5

Connections:
/Backplane Connector/USB3.D_N: CM5.136 (USB3-0-D_N); also elsewhere on the board
/Backplane Connector/USB3.D_P: CM5.134 (USB3-0-D_P); also elsewhere on the board
/Backplane Connector/USB3.RX_N: CM5.128 (USB3-0-RX_N); also elsewhere on the board
/Backplane Connector/USB3.RX_P: CM5.130 (USB3-0-RX_P); also elsewhere on the board
/Backplane Connector/USB3.TX_N: CM5.140 (USB3-0-TX_N); also elsewhere on the board
/Backplane Connector/USB3.TX_P: CM5.142 (USB3-0-TX_P); also elsewhere on the board
/CM5/DPHY0.C_N: CM5.127 (MIPI0_C_N); also elsewhere on the board
/CM5/DPHY0.C_P: CM5.129 (MIPI0_C_P); also elsewhere on the board
/CM5/DPHY0.D0_N: CM5.115 (MIPI0_D0_N); also elsewhere on the board
/CM5/DPHY0.D0_P: CM5.117 (MIPI0_D0_P); also elsewhere on the board
/CM5/DPHY0.D1_N: CM5.121 (MIPI0_D1_N); also elsewhere on the board
/CM5/DPHY0.D1_P: CM5.123 (MIPI0_D1_P); also elsewhere on the board
/CM5/DPHY0.D2_N: CM5.133 (MIPI0_D2_N); also elsewhere on the board
/CM5/DPHY0.D2_P: CM5.135 (MIPI0_D2_P); also elsewhere on the board
/CM5/DPHY0.D3_N: CM5.139 (MIPI0_D3_N); also elsewhere on the board
/CM5/DPHY0.D3_P: CM5.141 (MIPI0_D3_P); also elsewhere on the board
/CM5/DPHY1.C_N: CM5.187 (MIPI1_C_N); also elsewhere on the board
/CM5/DPHY1.C_P: CM5.189 (MIPI1_C_P); also elsewhere on the board
/CM5/DPHY1.D0_N: CM5.175 (MIPI1_D0_N); also elsewhere on the board
/CM5/DPHY1.D0_P: CM5.177 (MIPI1_D0_P); also elsewhere on the board
/CM5/DPHY1.D1_N: CM5.181 (MIPI1_D1_N); also elsewhere on the board
/CM5/DPHY1.D1_P: CM5.183 (MIPI1_D1_P); also elsewhere on the board
/CM5/DPHY1.D2_N: CM5.193 (MIPI1_D2_N); also elsewhere on the board
/CM5/DPHY1.D2_P: CM5.195 (MIPI1_D2_P); also elsewhere on the board
/CM5/DPHY1.D3_N: CM5.194 (MIPI1_D3_N); also elsewhere on the board
/CM5/DPHY1.D3_P: CM5.196 (MIPI1_D3_P); also elsewhere on the board
/CM5/High-Speed Serial/VBUS_EN: CM5.111 (VBUS_EN)
/CM5/PCIE.CLK_N: CM5.112 (PCIe_CLK_N); also elsewhere on the board
/CM5/PCIE.CLK_P: CM5.110 (PCIe_CLK_P); also elsewhere on the board
/CM5/PCIE.RX_N: CM5.118 (PCIe_RX_N); also elsewhere on the board
/CM5/PCIE.RX_P: CM5.116 (PCIe_RX_P); also elsewhere on the board
/CM5/PCIE.TX_N: CM5.124 (PCIe_TX_N); also elsewhere on the board
/CM5/PCIE.TX_P: CM5.122 (PCIe_TX_P); also elsewhere on the board
/CM5/PCIEsb.PWR_EN: CM5.106 (PCIE_PWR_EN); also elsewhere on the board
/CM5/PCIEsb.nCLKREQ: CM5.102 (PCIe_nCLKREQ); also elsewhere on the board
/CM5/PCIEsb.nRST: CM5.109 (PCIe_nRST); also elsewhere on the board
/CM5/PCIEsb.nWAKE: CM5.104 (PCIE_nWAKE); also elsewhere on the board
GND: CM5.107 (GND), CM5.108 (GND), CM5.113 (GND), CM5.114 (GND), CM5.119 (GND), CM5.120 (GND), CM5.125 (GND), CM5.126 (GND), CM5.131 (GND), CM5.132 (GND), CM5.137 (GND), CM5.138 (GND), CM5.144 (GND), CM5.150 (GND), CM5.155 (GND), CM5.156 (GND), CM5.161 (GND), CM5.162 (GND), CM5.167 (GND), CM5.168 (GND), CM5.173 (GND), CM5.174 (GND), CM5.179 (GND), CM5.180 (GND), CM5.185 (GND), CM5.186 (GND), CM5.191 (GND), CM5.192 (GND), CM5.197 (GND), CM5.198 (GND); also elsewhere on the board

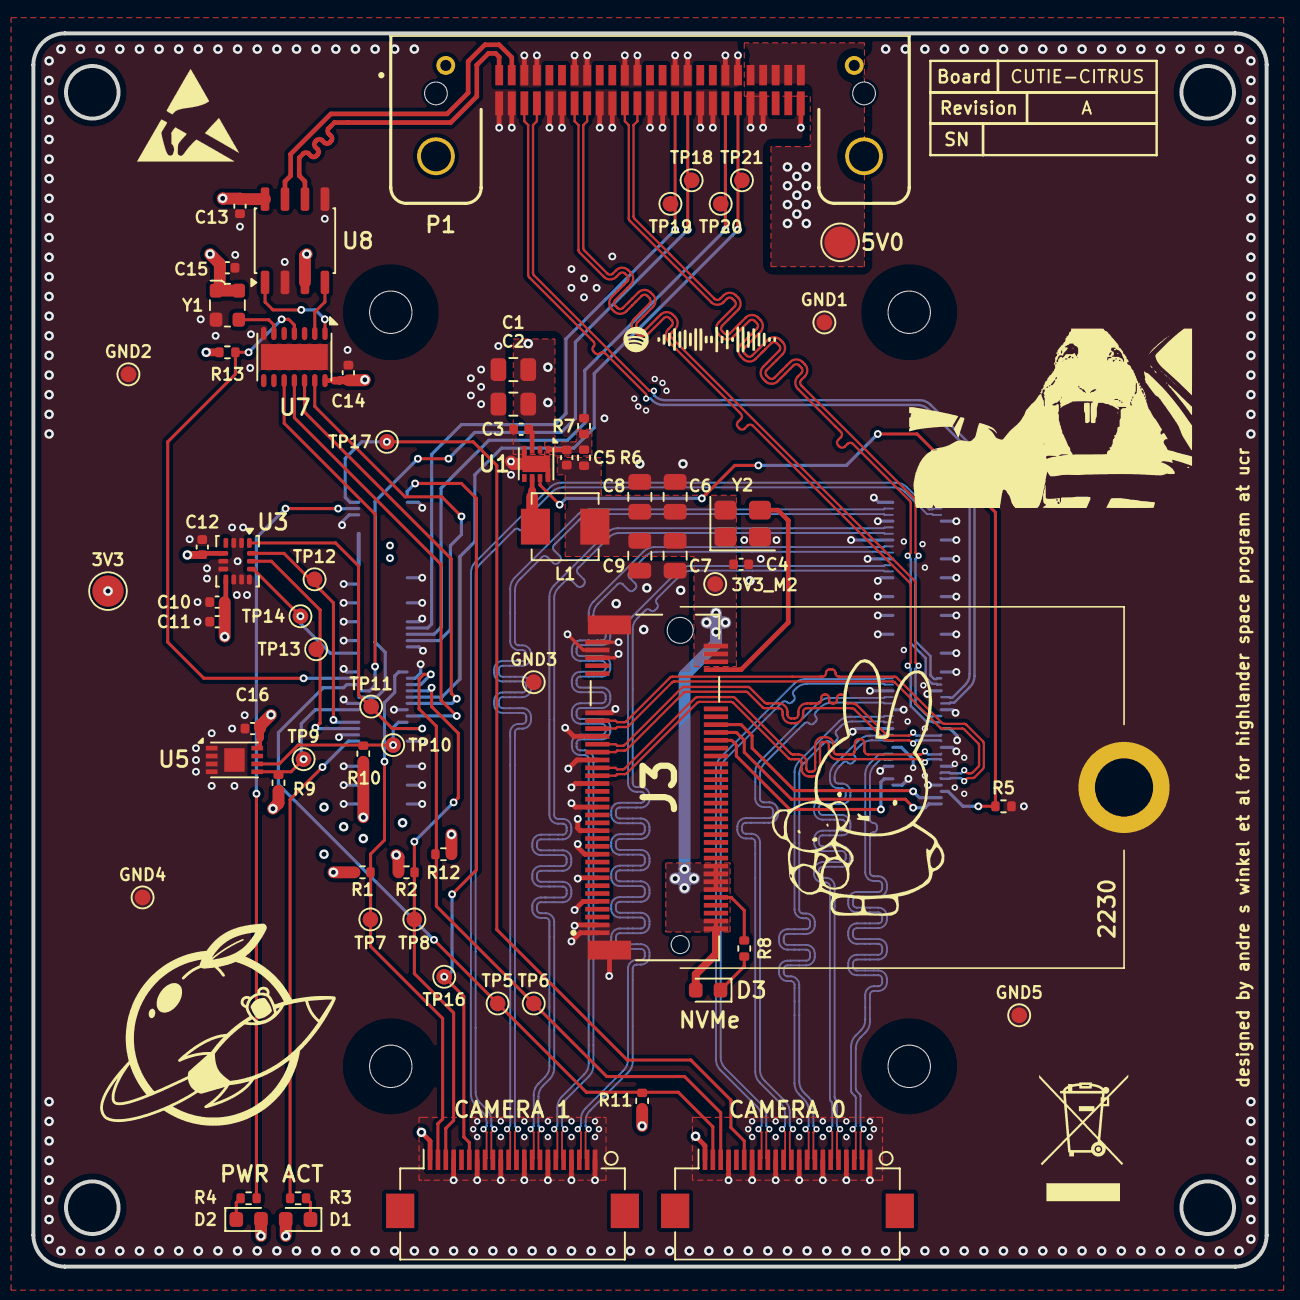
[picture p21: board CUTIE-CITRUS.kicad_pcb from above]

Board: 4 copper layers, 78.5 x 78.5 mm, 69 parts (1 on the bottom side), 75 nets.
