prestofuoco/CUTIE-CITRUS/(commit log)

2025-10-11 initial commit for kicad
    [CUTIE-CITRUS.kicad_pcb, CUTIE-CITRUS.kicad_sch]
2025-10-18 added misc
    [CUTIE-CITRUS.kicad_sch]
2025-11-03 saved libs to project, initialized hierarchy
    [CUTIE-CITRUS.kicad_sch, cm5.kicad_sch]
2025-11-11 added fpc connector
    [CUTIE-CITRUS.kicad_sch]
2025-11-15 quick push
    [CUTIE-CITRUS.kicad_sch]
2025-11-16 added m2 mkey conn, defined signals
    [CUTIE-CITRUS.kicad_pcb, CUTIE-CITRUS.kicad_sch, camera.kicad_sch, cm5.kicad_sch, nvme.kicad_sch, sensors.kicad_sch]
2025-11-17 restructured symbols, added footprints
    [CUTIE-CITRUS.kicad_pcb, CUTIE-CITRUS.kicad_sch, camera.kicad_sch, cm5.kicad_sch, nvme.kicad_sch]
2025-11-20 quick push, no major change
    [CUTIE-CITRUS.kicad_sch, cm5.kicad_sch, sensors.kicad_sch]
2025-11-23 added second camera, 6-axis imu
    [CUTIE-CITRUS.kicad_sch, camera.kicad_sch, cameras.kicad_sch, cm5.kicad_sch, nvme.kicad_sch, sensors.kicad_sch]
2025-11-24 annotations, small fixes
    [cameras.kicad_sch, cm5.kicad_sch, nvme.kicad_sch, sensors.kicad_sch]
2025-11-25 extra abstraction layer for cm5 conns.
    [CUTIE-CITRUS.kicad_pcb, CUTIE-CITRUS.kicad_sch, cameras.kicad_sch, cm5-gpio.kicad_sch, cm5-serial.kicad_sch, cm5.kicad_sch, nvme.kicad_sch, sensors.kicad_sch]
2025-11-28 abstractified pcie sideband sigs
    [CUTIE-CITRUS.kicad_sch, cm5-serial.kicad_sch, cm5.kicad_sch, nvme.kicad_sch]
2025-11-28 updated top-level schematic image
2025-12-11 neo m8m impl.
    [CUTIE-CITRUS.kicad_pcb, CUTIE-CITRUS.kicad_sch, cm5-gpio.kicad_sch, cm5-serial.kicad_sch, cm5.kicad_sch, nvme.kicad_sch, sensors.kicad_sch]
2025-12-12 prepared usb3, abstracted cameras, backplane connector
    [CUTIE-CITRUS.kicad_pcb, CUTIE-CITRUS.kicad_sch, backplane.kicad_sch, cam0.kicad_sch, cameras.kicad_sch, cm5-gpio.kicad_sch, cm5-serial.kicad_sch, cm5.kicad_sch]
2025-12-12 un-abstraction, footprints, layout edge cuts
    [CUTIE-CITRUS.kicad_pcb, CUTIE-CITRUS.kicad_sch, cam0.kicad_sch, cameras.kicad_sch, cm5-serial.kicad_sch, nvme.kicad_sch, sensors.kicad_sch]
2025-12-12 moved TPs
    [CUTIE-CITRUS.kicad_pcb, CUTIE-CITRUS.kicad_sch, cm5.kicad_sch]
2025-12-12 moved power TPs to cm5 sheet
    [CUTIE-CITRUS.kicad_sch, cm5-gpio.kicad_sch, cm5.kicad_sch, nvme.kicad_sch, sensors.kicad_sch]
2025-12-13 added temp sensors
    [CUTIE-CITRUS.kicad_pcb, sensors.kicad_sch]
2025-12-13 corrected temp sens i2c addr
    [sensors.kicad_sch]
2025-12-15 added potential backplane conn
    [CUTIE-CITRUS.kicad_pcb, cm5-gpio.kicad_sch]
2025-12-16 added conns to backplane
    [CUTIE-CITRUS.kicad_pcb, CUTIE-CITRUS.kicad_sch, backplane.kicad_sch, cm5-gpio.kicad_sch, cm5.kicad_sch]
2025-12-19 removed ublox
    [CUTIE-CITRUS.kicad_pcb, CUTIE-CITRUS.kicad_sch, cm5-gpio.kicad_sch, cm5-serial.kicad_sch, cm5.kicad_sch, sensors.kicad_sch]
2025-12-19 defined can
    [cm5-gpio.kicad_sch, cm5.kicad_sch]
2025-12-22 finished defining spi/i2c gpio, CAN, off-board signals
    [CUTIE-CITRUS.kicad_sch, backplane.kicad_sch, cm5-gpio.kicad_sch, cm5-serial.kicad_sch, cm5.kicad_sch, sensors.kicad_sch]
2025-12-23 starting layout
    [CUTIE-CITRUS.kicad_pcb, backplane.kicad_sch, cm5-serial.kicad_sch]
2025-12-24 high-speed signals initial
    [CUTIE-CITRUS.kicad_pcb]
2025-12-24 3v3_m2 and 5v0 power planes
    [CUTIE-CITRUS.kicad_pcb]
2025-12-24 add pcb view to readme
2025-12-26 power planes and sensor placement
    [CUTIE-CITRUS.kicad_pcb, backplane.kicad_sch, cm5-gpio.kicad_sch, cm5.kicad_sch]
2025-12-26 preliminary layout complete
    [CUTIE-CITRUS.kicad_pcb, cm5.kicad_sch]
2025-12-27 silkscreen edits
    [CUTIE-CITRUS.kicad_pcb, nvme.kicad_sch]
2025-12-27 drc fixes, verification
    [CUTIE-CITRUS.kicad_pcb]
2025-12-27 added missing 3d files, added slksc graphics
    [CUTIE-CITRUS.kicad_pcb]
2025-12-29 silkscreen, via stitching
    [CUTIE-CITRUS.kicad_pcb, cameras.kicad_sch]
2025-12-29 tp and gnd vias fixes
    [CUTIE-CITRUS.kicad_pcb]
2025-12-29 redid gpio layout, removed one temp sensor, bom
    [CUTIE-CITRUS.csv, CUTIE-CITRUS.kicad_pcb, backplane.kicad_sch, cameras.kicad_sch, cm5-gpio.kicad_sch, cm5-serial.kicad_sch, cm5.kicad_sch, nvme.kicad_sch]
2025-12-29 add layout pdf
    [CUTIE-CITRUS.kicad_pcb]
2026-01-15 added fabrication outputs, replaced imu drop-in og imu was out of stock everywhere, invensense drop-in replacement
    [CUTIE-CITRUS-B_Cu.gbl, CUTIE-CITRUS-B_Mask.gbs, CUTIE-CITRUS-B_Paste.gbp, CUTIE-CITRUS-B_Silkscreen.gbo, CUTIE-CITRUS-Edge_Cuts.gm1, CUTIE-CITRUS-F_Cu.gtl, CUTIE-CITRUS-F_Mask.gts, CUTIE-CITRUS-F_Paste.gtp]
2026-01-16 fixes for fab
    [CUTIE-CITRUS.kicad_pcb, nvme.kicad_sch, sensors.kicad_sch]
2026-01-16 restructure for embedded
    [CUTIE-CITRUS-B_Cu.gbl, CUTIE-CITRUS-B_Mask.gbs, CUTIE-CITRUS-B_Paste.gbp, CUTIE-CITRUS-B_Silkscreen.gbo, CUTIE-CITRUS-Edge_Cuts.gm1, CUTIE-CITRUS-F_Cu.gtl, CUTIE-CITRUS-F_Mask.gts, CUTIE-CITRUS-F_Paste.gtp]
2026-01-25 fixed for case sensitivity
